DataDudeCM/LightWand/images/test_portrait.jpg

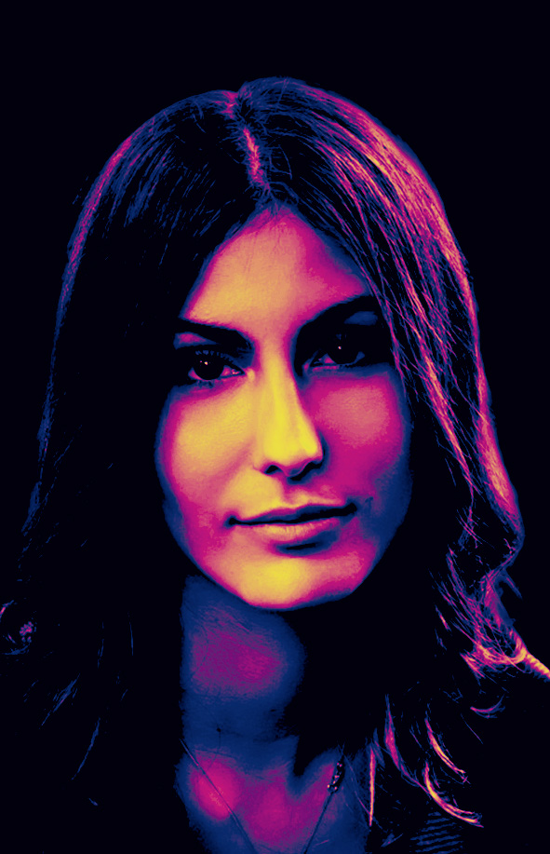
images/test_portrait.jpg
