DataDudeCM/LightWand/images/test.jpg

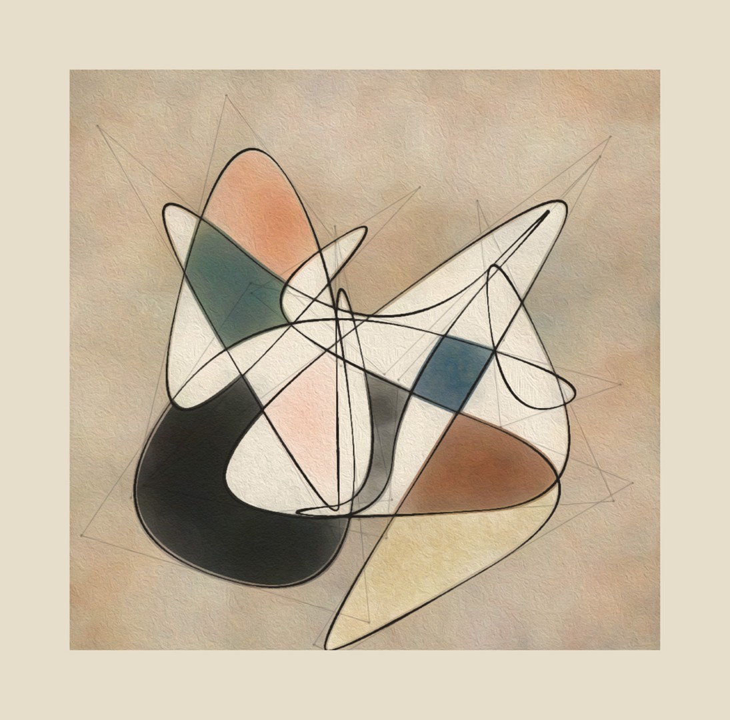
images/test.jpg
