DataDudeCM/LightWand/docs/frame-sequence-plan.md

# Plan: frame sequences, previews, and generators

**Status:** steps 1–6 done (sequence format + `wand.play`; paint simulator
`preview.py` + viewer `preview_paint.py`; perlin generator + `wand.stream`;
flow viewer `preview_flow.py`; snapshots in the flow viewer). Also done: modes
moved to `frame_effects.py`; `image_paint` paints images or sequences.
Step 3 live mode works on the wand (2026-10-07; led to gamma correction).
Step 6 done in the art repo (`art/common/js/wand-capture.js`): a rule 90 automaton
captured from p5 and checked in the previews (2026-10-07). Painting a sequence on
the wand uses the same `play()` path as images; the sequence loading is tested off-wand.
Usage summary written (README "How to Use"). Step A done: `generate.py` (screen / wand /
both), `generators/automaton.py`, `perlin_effect.py` retired. Step B done: `paint.py`
(screen / wand / both) replaces `preview_paint.py` and `image_paint.py`; script names
updated in `art/docs/wand-capture.md` (art repo). Older notes below use the old names.
Since then: `particles`, `particles_physics` (braided strands), `smoke` and `ribbons` generators.
Optional later: steps 7-8, speed profiles.
**Date:** 2026-10-07

## Goal

Make it easy to create, preview, and play wand content of any kind: photos, text,
procedural effects (perlin, smoke, flame, automata), and *Nature of Code* sketches.

- **Pre-generate on the laptop by default.** Then optionally send the result to the wand,
  either painted once (like `image_paint` today) or looped continuously.
- **Live generation still works** for Python generators (endless smoke, flame, etc.).
- **Preview before shooting:**
  - a paint simulator: "what will the photo look like?"
  - a flow viewer: "what is the wand putting out over time?"
- **Snapshots:** spot a good moment in a flow and turn exactly that stretch into a painting.

Origin: discussion in the ChatGPT "Light Wand Improvements" thread (two-mode preview
idea), plus the decision to center everything on pre-generated sequences.

## Core idea: a frame sequence is an image

A sequence of 100-pixel frames is an image that is 100 pixels tall, with one column per frame.
This is the same "tip up, sweep right" layout that `image_frames` already produces.

A **FrameSequence** is saved as two files:

- `name.png`: the strip (100 px tall, N frames wide). It opens in any image viewer.
  A minute at 100 fps is 6,000 × 100 px, which is small.
- `name.json`: metadata, for example:

```json
{
  "fps": 100,
  "generator": "perlin",
  "params": {"x_scale": 0.08, "palette": "ember"},
  "seed": 999,
  "source": null,
  "notes": ""
}
```

Because the format is just a file, generators can be written in **Python or p5.js**.
Everything downstream (previews, wand playback) reads the same files.

## Architecture

```
Sources                      Artifact                   Outputs
───────                      ────────                   ───────
photo / text ─┐                                     ┌─ paint simulator
Python gen   ─┼─► FrameSequence (PNG + JSON) ───────┼─ flow viewer
p5.js sketch ─┘   (or a live frame iterator)        ├─ wand: paint once
                                                    └─ wand: loop / live
```

Rules:

- **Generators** produce frames and know nothing about the wand, timing, or orientation.
  Python generators are iterators that yield frames one at a time. The same code can fill a
  list for saving or drive the wand live. They must be deterministic given a seed.
- **Sequences** are always stored in the standard layout. Orientation (`TIP`/`SWEEP`)
  is applied at paint time by `image_frames.orient`, as it is today.
- **Playback** lives in `LightWand.play(frames, seconds, loop=False)`. This is the
  "extract on second use" step from the orientation plan, and this work is that second use.
- **Shoot setup** (countdown beeps, repeats, sweep printout) stays in the painting script.
- **Modes** (`bands`, `sparse_noise`, …) move to a shared `frame_effects` module. They
  transform a sequence, so they apply to any source.

## Where code goes

| Piece | Language | Location |
|---|---|---|
| FrameSequence (save/load/slice) | Python | `python/sequence.py` |
| Wand playback (`play`) | Python | `python/lightwand.py` |
| Picture → frames | Python | `python/image_frames.py` (unchanged) |
| Frame effects (modes) | Python | `python/frame_effects.py` |
| Python generators | Python | `python/generators/` |
| Paint simulator + flow viewer | Python | `python/preview.py` (or split later) |
| p5 capture helper | JS | `art/common/js/wand-capture.js` (art repo) |
| p5 generator sketches | JS | in `art/` (art repo) |
| Painting script | Python | `python/image_paint.py`, slimmed to: load sequence/image → orient → play |

**p5 lives in the art repo (decided 2026-10-07).** The helper is a general tool for any
p5 sketch, so it goes with the other shared JS in `art/common/js/`, and wand sketches,
new or adapted from existing art, live in `art/` too. One Live Server rooted at `art/`
serves them all. The only link between the repos is the output files: a sketch saves a
sequence, and lightWand's Python tools read it. A sketch inside `lightWand/` couldn't
load `art/common/` from a server rooted at `lightWand/` (files outside a server's root
aren't served), which is another reason not to split them.

## Language decision

- **Python core:** sequences, playback, previews. These drive the wand and reuse
  `image_frames`, so they belong in one process with no bridge.
- **p5.js for *Nature of Code* generators:** stay close to the book, tweak live in the
  browser, and reuse `art/common/js/palette.js` and the Live Server workflow.
- **Python for other generators:** existing scripts are Python, and numpy is plenty for 100 px.

### How a p5 generator makes wand frames

Run the full 2D simulation on the canvas as usual. Each simulation step, sample **one
line of pixels** (for example a row across the canvas), resize it to 100 px, and append
it as a frame. `wand-capture.js` collects the frames and saves the PNG strip + JSON.

- Capture **one frame per simulation step**, not per wall-clock tick. Combined with
  `randomSeed`/`noiseSeed`, the output is then deterministic and snapshots are reproducible.
- Browser saves go to the Downloads folder. **For now, move them by hand** into
  `lightWand/sequences/` (gitignored). Automating that can come later if it gets tedious.

### Live vs pre-generated

| | Python generator | p5 generator |
|---|---|---|
| Pre-generate → paint once / loop | yes | yes |
| Live, endless | yes (iterator → `play`) | needs a bridge (browser → websocket → Python → UDP). Later, only if needed |

## Previews

### Paint simulator

Places each frame where it would land in the photo, given:

- `TIP` / `SWEEP` (reuses the orientation logic)
- exposure length, sweep distance (`LIT_LENGTH_INCHES`)
- optional: LED spacing/gaps, diffusion blur, brightness accumulation, uneven speed

The orientation test from the previous plan already did the core placement. This step
grows it into a real tool that outputs a preview image.

Later additions (wanted, not in step 2):

- **Speed profiles:** uneven sweep speed (slow start, acceleration, pauses), e.g. to
  reproduce the squeezed top seen in real photos.
- **Preview from `image_paint`:** a `PREVIEW = True` setting that shows the simulated
  photo before shooting.

### Flow viewer

A window that shows the newest frame at the "wand" edge and scrolls older frames away
across the screen.

- Settings: scroll direction (follows `TIP`/`SWEEP`), pixels per frame (simulated speed),
  history length, blur.
- Plays a saved sequence or a live Python generator.
- Shows the current frame number / time so it's clear where you are.

### Snapshots

While watching a flow, press a key to mark a start and an end. The result:

- a slice of the sequence saved as a new strip + JSON (with `source` pointing to the
  original, the frame range, and the seed/params), and
- optionally opened in the paint simulator.

## Build order

1. **Sequence format + `wand.play`.** Save/load/slice, paint-once and loop playback.
   Refactor `image_paint` to use them (behavior unchanged).
2. **Paint simulator.**
3. **First Python generator.** Port `perlin_effect.py` to the generator interface.
4. **Flow viewer.**
5. **Snapshots.**
6. **p5 `wand-capture.js`**, built in the art repo (see `art/docs/wand-capture.md`).
   Back here afterwards: check its output in `preview_flow` / `preview_paint`, then paint it.
7. *(Optional, later)* p5 live bridge.
8. *(Optional, later)* upload a sequence to the ESP32 and play it from its own memory
   (works without the laptop, no Wi-Fi timing jitter). The file format shouldn't block this.

Each step should be usable on its own, and each gets its own small plan or commit.

**When the plan is done:** write a short "how to use" summary (generate, save, preview,
paint, stream) for the README.

## Next: two tools, each with screen / wand / both output (decided 2026-10-07)

Organize by activity, not by output. Each tool gets `OUTPUT = "screen" | "wand" | "both"`.

| Tool | Activity | Replaces |
|---|---|---|
| `python/generate.py` | continuous flow from a generator (or a looping saved sequence), until stopped | `preview_flow.py`, `perlin_effect.py` (retired), the never-built `run_generator.py` |
| `python/paint.py` | one fixed-length exposure for a photo | `preview_paint.py` + `image_paint.py` |

**Step A: `generate.py`** (done)
- Rename `preview_flow.py` → `generate.py`; add `OUTPUT`. Wand output sends each frame as it's
  taken on the clock (`LightWand(gamma=WAND_GAMMA, brightness=WAND_BRIGHTNESS)`).
  "both" = watch the scroll while the wand runs; snapshots still work.
- Caveat: with "both", screen drawing can delay a wand frame by a few ms. Fine for
  watching; photos go through `paint.py`.
- Add a key to save a stretch (covers `perlin_effect.py`'s save mode), then **retire
  `perlin_effect.py`**.
- Add a Python cellular automaton generator, `generators/automaton.py`:
  `frames(seed, rule, num_leds, start)`. Like every generator: deterministic for a seed,
  and `start=N` begins at frame N (snapshots rely on it). `edges="fixed"` matches the
  p5 sketch in `art/generative/cellularAutomata` exactly (the default is `"wrap"`).

**Step B: `paint.py`** (done)
- Merge `preview_paint.py` and `image_paint.py`.
  - screen: today's interactive paint preview.
  - wand: today's countdown + paint.
  - both: preview first, adjust TIP/SWEEP/mode with the keys, ENTER paints exactly that.
- Fixes the preview ignoring `image_paint`'s MODE CONTROLS (and covers the planned
  `PREVIEW = True` idea).

Update README "How to Use", DESIGN.md references and this plan with each step.
Each step gets its own short plan and commit.

## Ideas for later

**Presets (wanted, 2026-10-07).** Save the settings of a good run and call it back.

- A preset is a small JSON file in `presets/`, e.g. `presets/braid_tight.json`: generator
  name, its settings, fps, and optionally viewer settings (TIP / SWEEP, scroll speed).
- `python generate.py --preset braid_tight` overrides the settings at the top of the file
  (same pattern as `paint.py --output`).
- A key in `generate.py` saves the current run as a new preset.
- Saved sequences' JSON already records generator, params and seed, so a snapshot could
  be loaded as a preset (see a snapshot you like, run it live again).
- Later, the same for `paint.py`: shoot-setup presets (orientation, mode, exposure,
  brightness).

**Pendulum (and later spin) light painting (wanted, 2026-10-08).** Goal: precessing,
nested colored hoops (spirograph-like) like the reference photo the user shared.

- Pendulum first (no center spin mount yet): hang the wand from the electronics end
  (eye-screw, DESIGN.md §7.2), swing it in an ellipse, camera on the floor looking up.
  The ellipse precesses and shrinks on its own; each lit LED draws a copy scaled by its
  distance from the pivot, so a few colored dots give nested colored hoops.
- Start with static dots (4-5 single LEDs, one color each), then dots moving along the
  wand (`particles` with slow motion). Dot rhythms tied to the swing period (~1.8 s for a
  ~1.2 m rigid wand hung from its end) give repeating petal / rosette shapes.
- Possible code: a simple "dots" generator (fixed LEDs, colors, optional in/out rhythm in
  swing periods); a pendulum preview in `paint.py` (elliptical swing seen from below,
  precession and decay) to design patterns on screen.
- Later, with a center pivot: spin mode (each LED draws a circle; in/out rhythm relative
  to rpm gives spirograph curves; a slow tilt of the spin plane gives the 3D hoop look).
  The IMU (DESIGN.md §11) could lock patterns to the real motion.

**Light portraits (built, 2026-10-09; not yet tried on the wand).** Noise glow + sparkles and a palette tint for
portrait photos painted vertically. See `docs/portrait-effects-plan.md`.

**Related, discussed but not wanted yet:**

- Live tuning in `generate.py`: universal keys (wand brightness, fps, next / previous seed,
  restart) plus hot reload of the settings file; generator-specific keys only if hot
  reload feels clumsy. Catches: snapshots after a live change must be saved from the
  played frames, and stateful generators (`particles_physics`, `automaton`) jump when
  restarted with new settings.
- Show the sweep speed matching the scroll in the caption (e.g. "2 px/frame ≈ 12 in/s"),
  from `LIT_LENGTH_INCHES` and fps.

## Decisions

- **Saved sequences** go in `sequences/` at the repo root, which is **gitignored**.
  They can be regenerated from the seed. A favorite can still be committed deliberately.
- **Timing:** one fps per sequence (stored in the JSON). Playback can stretch or
  compress to a chosen exposure length. Per-frame timing isn't needed for now.
- **Loop playback** runs until Ctrl+C, with an optional limit (loop count or seconds).
- **Viewer toolkit:** pygame (already installed, also used in `art/python/`). The paint
  simulator and the flow viewer share window code.

## Open questions

- ~~Should LED brightness/gamma be modeled in the simulator so previews match photos?~~
  Decided the other way round: the wand is gamma-corrected (`LightWand(gamma=2.2)`) so it
  matches the previews (DESIGN.md §5.3). Brightness is still not modeled.

## Not changing

- Firmware and the UDP frame protocol.
- `image_frames.py` and the `TIP`/`SWEEP` design.
- Brightness approach (DESIGN.md §5.3).
