DataDudeCM/LightWand/images/abstract_doodle.jpg

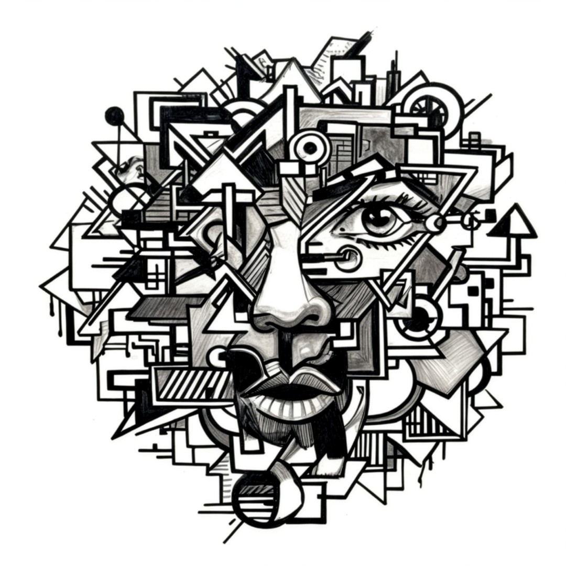
images/abstract_doodle.jpg
