DataDudeCM/LightWand/images/antelope.jpg

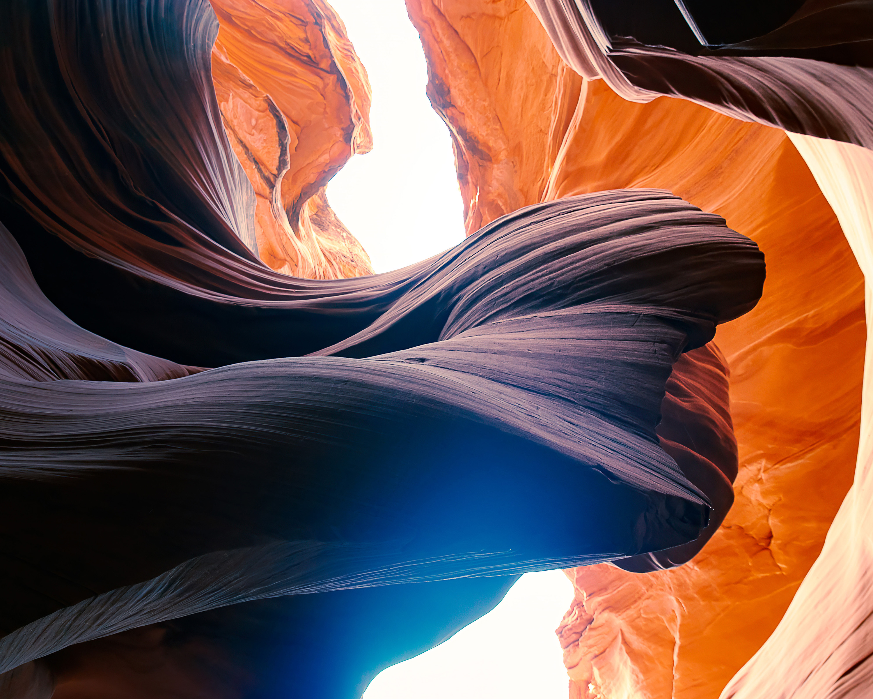
images/antelope.jpg
