DataDudeCM/LightWand/images/closeup.jpg

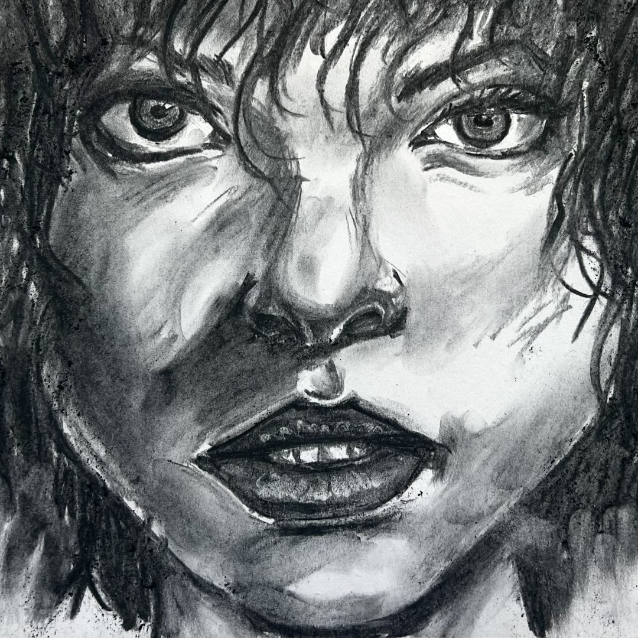
images/closeup.jpg
