DataDudeCM/LightWand/images/Ellie.jpg

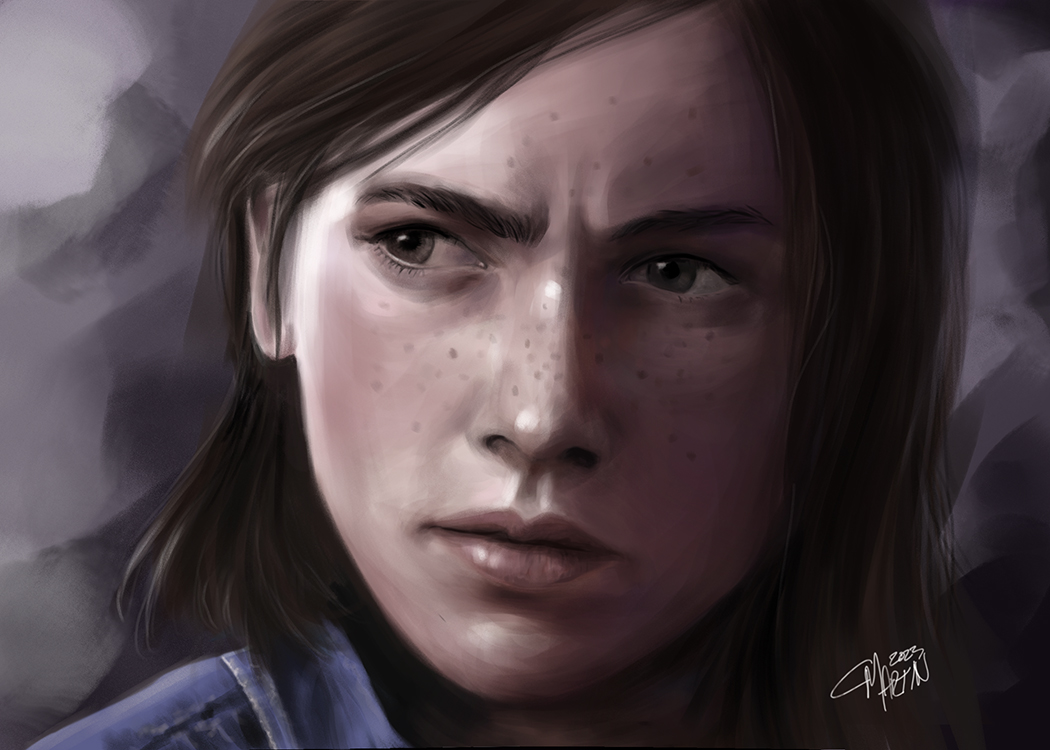
images/Ellie.jpg
