DataDudeCM/LightWand/images/jinx.jpg

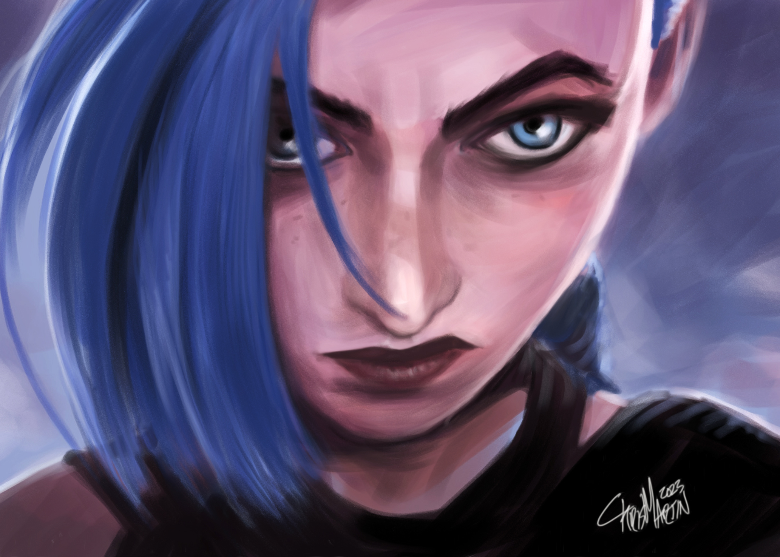
images/jinx.jpg
