DataDudeCM/LightWand/images/starburst.jpg

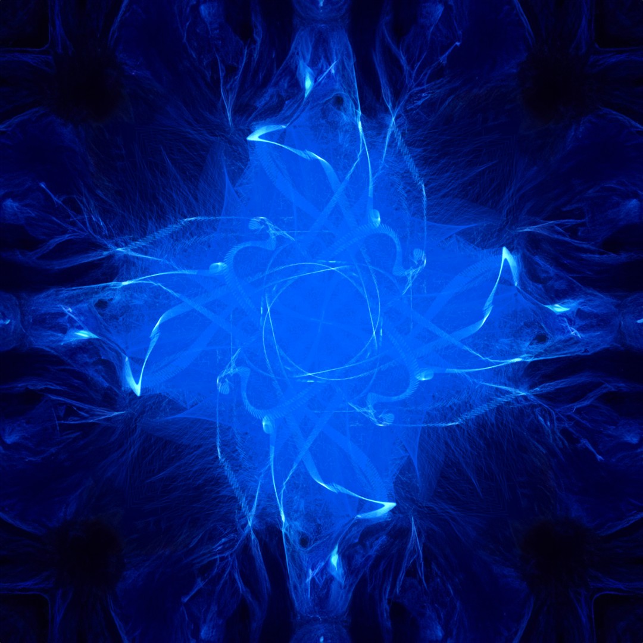
images/starburst.jpg
