DataDudeCM/LightWand/(commit log)

2026-10-07 Add TIP/SWEEP wand orientation for image painting
    New image_frames helper rotates/flips a picture for how the wand is
    held and moved (as seen by the camera), then slices it into frames.
    image_paint uses it in place of REVERSE. Invalid combinations fall
    back to up/right with a warning.
2026-10-07 Raise LED brightness to 120, disable dithering; document brightness lesson
    Low LED values plus FastLED temporal dithering (driven by Wi-Fi packet
    timing) caused dimmer bands in long exposures. Keep LED values high
    and dim with the camera instead. DESIGN.md records this and the new
    wand orientation settings.
2026-10-07 Add sweep-distance printout and countdown beeps to image_paint
    Prints how far and how fast to sweep for correct proportions, from
    LIT_LENGTH_INCHES and the oriented image shape. Countdown beeps
    (3-2-1, go) sound LEAD_IN_SECONDS before the first frame without
    shifting frame timing, so passes stay in sync with the camera.
    Remove image_paint_v0.py.
2026-10-07 Add frame sequence plan
    Plan for pre-generated frame sequences (PNG strip + JSON), wand
    playback, paint simulator, flow viewer, snapshots, and Python/p5
    generators. Includes decisions on storage, timing, and looping.
2026-10-07 Add FrameSequence and LightWand.play; image_paint uses play
    sequence.py saves/loads frame sequences as a PNG strip plus JSON
    metadata (fps, generator, params, seed, source) and supports slicing.
    LightWand.play() handles timed playback with absolute timing,
    stretch-to-seconds, and looping until Ctrl+C or a limit.
    image_paint now applies modes up front and plays via wand.play();
    output is frame-for-frame identical to before. sequences/ is gitignored.
2026-10-07 Add original simulator / live flow viewer concept
    The ChatGPT write-up that led to docs/frame-sequence-plan.md, kept
    for reference.
2026-10-07 Add paint simulator and preview window
    preview.simulate_paint() estimates the long-exposure photo for a set
    of frames: TIP/SWEEP placement, photo proportions from lit length and
    sweep distance, LED gaps, optional diffusion blur, gain. Steady speed
    for now. preview_paint.py shows it in a pygame window (arrow keys for
    TIP, space flips SWEEP, +/- sweep, G/B gaps/blur, S saves to
    previews/, gitignored). image_frames gains unorient().
2026-10-07 Add perlin generator and LightWand.stream (frame sequence step 3)
    generators/perlin.py yields frames forever from frames(seed, **settings),
    with start=N to regenerate any range. This sets the pattern for future
    generators: no wand or timing code. palette_color moves into palette.py.
    LightWand.stream plays a live generator on the same absolute clock and
    Ctrl+C blackout as play(). perlin_effect.py now has RUN = live / save;
    save writes a FrameSequence to ../sequences/. Frames are identical to the
    old script for the same seed.
2026-10-07 Update frame sequence plan status: step 3 done
2026-10-07 Add flow viewer (frame sequence step 4)
    preview_flow.py shows the wand's output over time: newest frame at the
    leading edge, older frames scrolling away behind it. Plays a saved
    sequence (looping) or a live generator from generators/, at true speed,
    with frame number and time shown. Keys: arrows/space orientation,
    P pause, , and . step, +/- scroll speed, G LED gaps.
    simulate_flow() in preview.py does the drawing (pixel exact, no window).
    Window helpers shared with preview_paint move to preview_window.py;
    preview_paint draws the same as before.
2026-10-07 Add snapshots to the flow viewer (frame sequence step 5)
    In preview_flow, [ and ] mark a start and end on the newest frame on
    screen, S saves that range to ../sequences/<name>_<start>-<end>, and O
    opens the last snapshot in the paint preview. Generator snapshots are
    re-run from the seed (start=N), so the JSON reproduces them exactly;
    sequence snapshots use FrameSequence.slice. Marks show as thin white
    lines in the trail; a range that ends before it starts is refused.
    preview_paint.py takes an optional file path on the command line.
2026-10-07 Move modes to frame_effects; image_paint paints sequences
    frame_effects.py holds the image_paint modes (full_field, sparse_random,
    sparse_noise, bands) as effects on a whole list of frames, so they work
    on any source. Output is identical to the old code.
    image_frames gains load_input / input_frames (image or saved sequence),
    shared by image_paint and preview_paint. image_paint's INPUT_FILE
    (was IMAGE_FILE) can be a sequence, painted as-is; EXPOSURE_SECONDS =
    None plays it at its own length. Images produce the same frames as
    before.
    preview_paint gets MODE and an M key to preview each mode.
2026-10-07 Add LED gamma correction to LightWand (default 2.2)
    WS2812B output is linear but screens and cameras are not, so mid and
    dark values looked too bright on the wand and colors washed out (the
    industrialSun gold looked creamy). A perlin A/B test on the wand showed
    gamma 2.2 much closer to the preview.
    LightWand(gamma=2.2) applies gamma then brightness in show() through a
    lookup table, rebuilt when brightness or gamma changes; stored pixels
    are unchanged. gamma=1.0 sends exactly the old bytes. perlin_effect and
    image_paint expose WAND_GAMMA. DESIGN.md 5.3 records the lesson and the
    dark-level cost; image_paint brightness to be revisited on next shoot.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
2026-10-07 Add generate.py (screen/wand/both) and automaton generator; retire perlin_effect
    preview_flow.py becomes generate.py with OUTPUT = screen | wand | both.
    wand streams the generator with no window until Ctrl+C; both sends each
    frame to the wand as the flow view takes it (pause holds the frame,
    stepping sends the one stepped to; quitting blacks out). S with no
    marks saves everything played so far. Screen output is unchanged.
    generators/automaton.py: 1D elementary cellular automaton, one
    generation per frame, with center/random start and wrap/off/fixed
    edges (fixed matches the p5 rule 90 sketch exactly).
    perlin_effect.py is retired: generate.py with GENERATOR = perlin covers
    both its live and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
2026-10-07 Merge preview_paint and image_paint into paint.py (screen/wand/both)
    paint.py does one fixed-length exposure with OUTPUT = screen | wand |
    both. screen is the old paint preview (identical output); wand is the
    old image_paint shoot (same printout, frames and play calls); both
    previews first, and ENTER in the window paints exactly the previewed
    TIP/SWEEP/mode, printing the sweep length set with +/-; the window
    closes while painting and returns afterwards.
    The preview now uses MODE CONTROLS for each mode. The wand is found
    automatically (WAND_IP = None) instead of a fixed IP. An optional path
    and --output override work on the command line; generate.py's O key
    opens paint.py <snapshot> --output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
2026-10-09 smoke: highlight wisps; tuned generate.py settings
    highlight_fraction / highlight_boost make a share of the wisps glow
    much brighter, drawn last with add blending on top of the smoke.
    Picked from an existing per-particle value, so output with highlights
    off is unchanged; re-picked on each respawn.
    generate.py: current smoke and ribbons tuning, smoke with highlights.
2026-10-10 Light portrait effects: noise_glow and palette_tint
    frame_effects: noise_glow dims the image to a base level and brightens
    patches where an OpenSimplex field peaks (round in the photo via the
    sweep ratio), with deterministic sparkles inside them; background
    pixels are left alone. palette_tint recolors by brightness through a
    palette, keeping brightness so black stays black.
    paint.py: MODE can be a list applied in order; MODE CONTROLS for both
    effects; noise_glow gets the sweep ratio, and new sparkles per repeat
    pass (all versions made before the first pass). Existing modes and
    output are unchanged.
    palettes.json: neonPortrait. README and plans updated.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
